alex-nemo/pic18f-raspberry-ups.X/pcb/pic18f-raspberry-ups-prototype.jpg

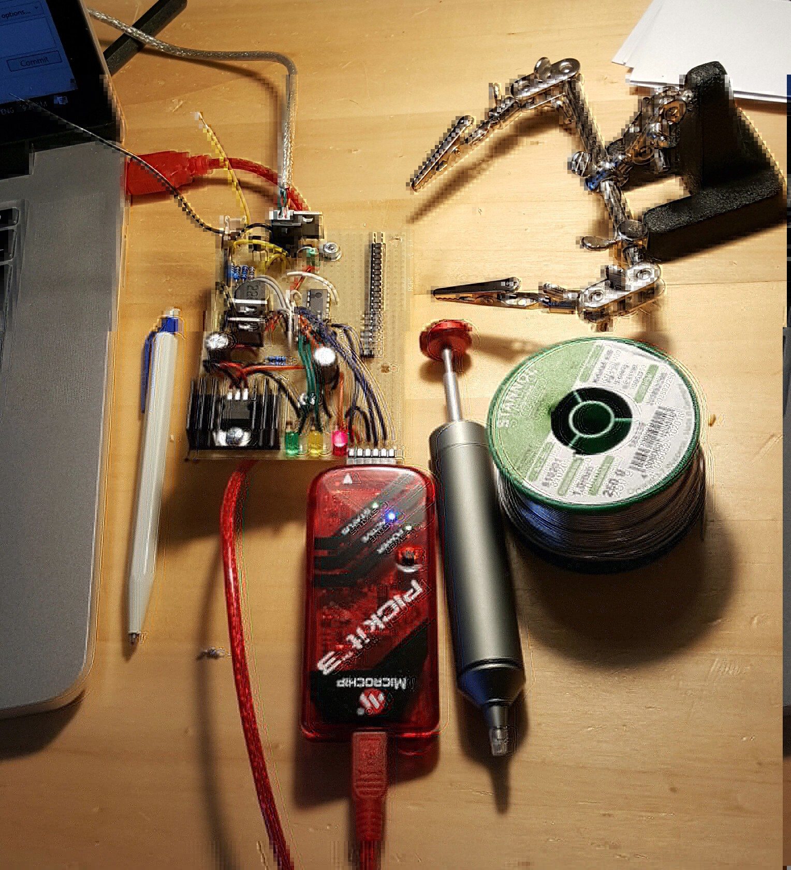
pcb/pic18f-raspberry-ups-prototype.jpg
