alex-nemo/pic18f-raspberry-ups.X/pcb/pic18f-raspberry-ups-3d.png

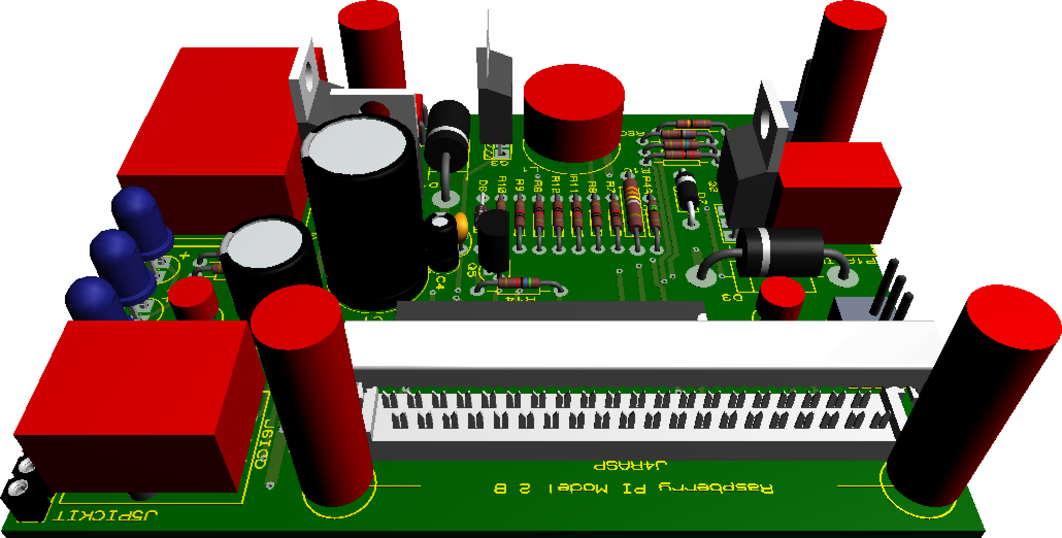
pcb/pic18f-raspberry-ups-3d.png
