alex-nemo/pic18f-raspberry-ups.X/pcb/gerber/pic18f-raspberry-ups - CADCAM Bottom Solder Resist.TXT

G04 PROTEUS RS274X GERBER FILE*
%FSLAX24Y24*%
%MOIN*%
%ADD72C,0.0400*%
%ADD71C,0.0024*%
%ADD17C,0.0800*%
%ADD14C,0.0700*%
%ADD18C,0.0900*%
%ADD73C,0.1000*%
%ADD30C,0.1600*%
%ADD16C,0.0600*%
%ADD22C,0.0503*%
%ADD24C,0.0413*%
%ADD25C,0.0080*%
G54D72*
X-11614Y+44488D03*
X-9645Y+24803D03*
X-35236Y+20866D03*
X-11614Y+41732D03*
X-30314Y+30708D03*
X-26377Y+24803D03*
X-31314Y+32677D03*
X-31329Y+27545D03*
X-34252Y+24346D03*
X-34251Y+21850D03*
X-22440Y+24803D03*
X-9645Y+39566D03*
X-16535Y+39566D03*
X-11614Y+38582D03*
X-10612Y+36048D03*
X-17324Y+36596D03*
X-17519Y+28740D03*
X-24409Y+28740D03*
X-21456Y+33661D03*
X-28469Y+33038D03*
X-20472Y+33661D03*
X-28914Y+32696D03*
X-28058Y+31497D03*
X-27339Y+31908D03*
X-26346Y+32285D03*
X-18298Y+34614D03*
X-18435Y+34134D03*
X-4724Y+33661D03*
X-12510Y+31977D03*
X-13538Y+31429D03*
X-17519Y+21850D03*
X-9645Y+20866D03*
X-18503Y+33661D03*
X-17305Y+33757D03*
X-14568Y+27094D03*
X-10947Y+27025D03*
X-8809Y+20059D03*
X-9055Y+25787D03*
X-27362Y+29724D03*
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
