alex-nemo/pic18f-raspberry-ups.X/pcb/gerber/pic18f-raspberry-ups - CADCAM Mechanical 1.TXT

G04 PROTEUS RS274X GERBER FILE*
%FSLAX24Y24*%
%MOIN*%
%ADD25C,0.0080*%
G54D25*
X-39173Y+18897D02*
X-1771Y+18897D01*
X-1771Y+46456D01*
X-39173Y+46456D01*
X-39173Y+18897D01*
X-34212Y+28700D02*
X-33818Y+28700D01*
X-33818Y+29960D01*
X-34212Y+29960D01*
X-34212Y+28700D01*
X-36653Y+28700D02*
X-36259Y+28700D01*
X-36259Y+29960D01*
X-36653Y+29960D01*
X-36653Y+28700D01*
X-35866Y+27165D02*
X-34606Y+27165D01*
X-34606Y+27559D01*
X-35866Y+27559D01*
X-35866Y+27165D01*
M00*
