alex-nemo/pic18f-raspberry-ups.X/documentation/1385285_GB_00_FB.EPS_400.jpg

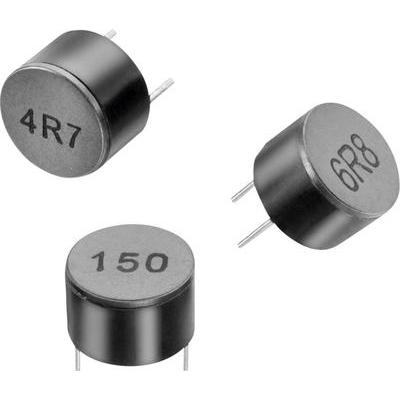
documentation/1385285_GB_00_FB.EPS_400.jpg
