alex-nemo/pic18f-raspberry-ups.X/documentation/L78S05CV.jpg

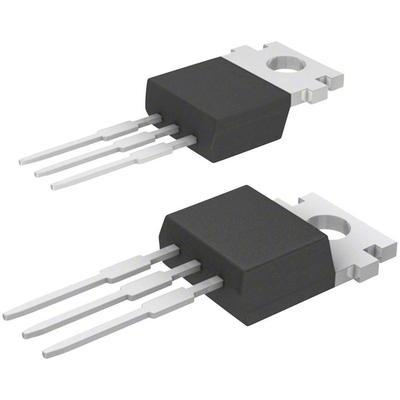
documentation/L78S05CV.jpg
