alex-nemo/pic18f-raspberry-ups.X/documentation/US18650VTC5A.jpg

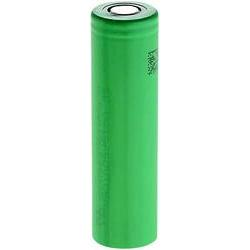
documentation/US18650VTC5A.jpg
