alex-nemo/pic18f-raspberry-ups.X/pcb/pic18f-raspberry-ups-pcb.png

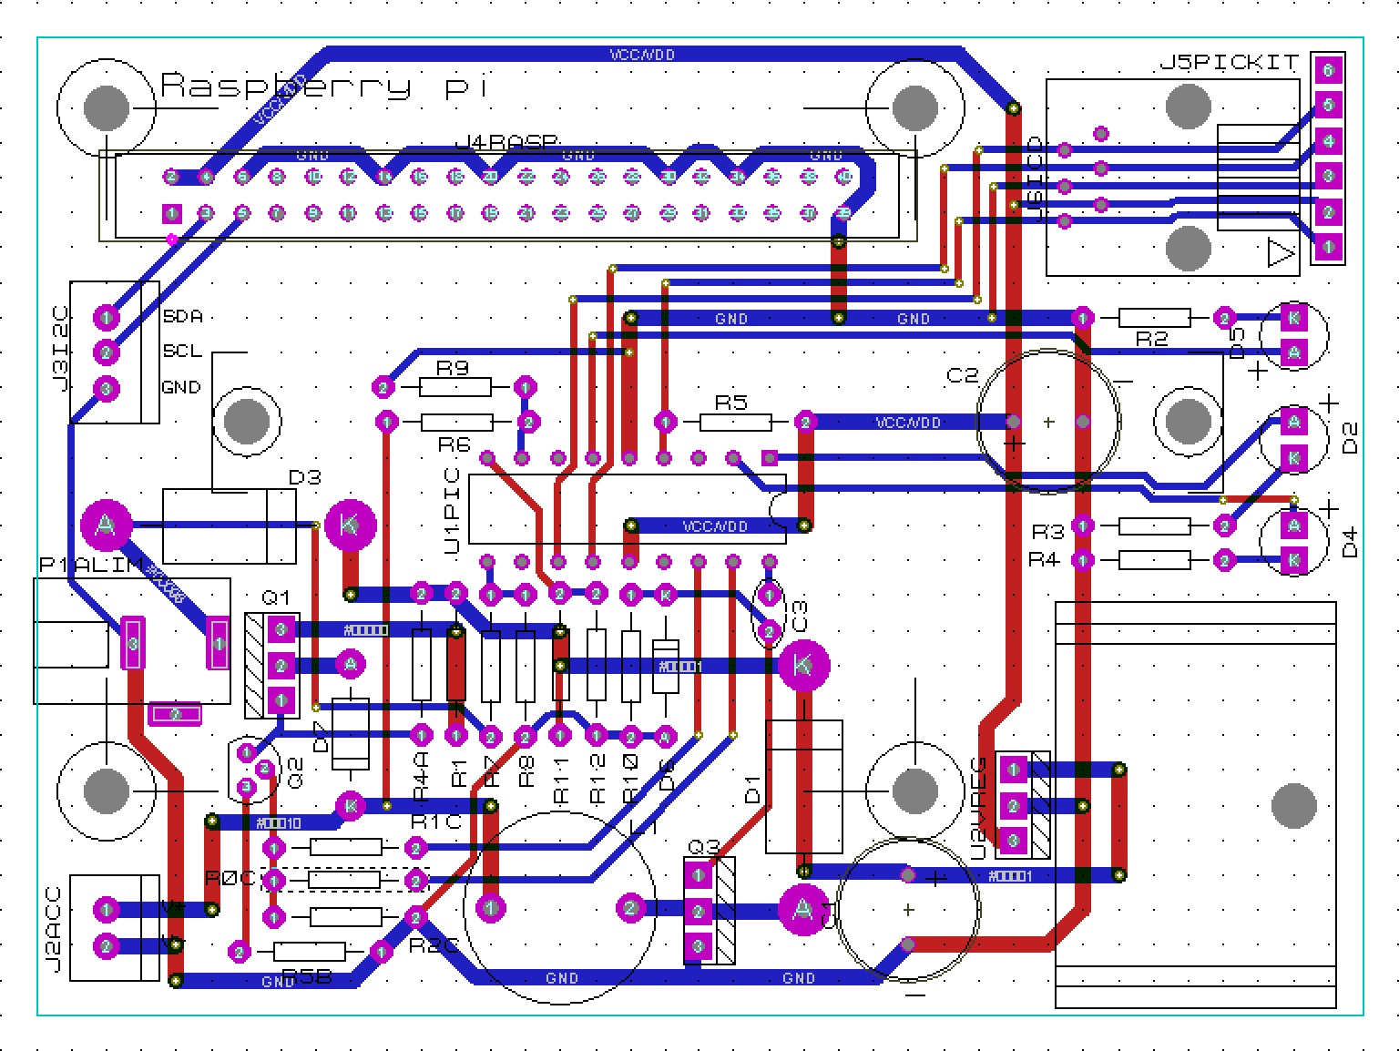
pcb/pic18f-raspberry-ups-pcb.png
