alex-nemo/pic18f-raspberry-ups.X/pcb/pic18f-raspberry-ups-pcb.pdf

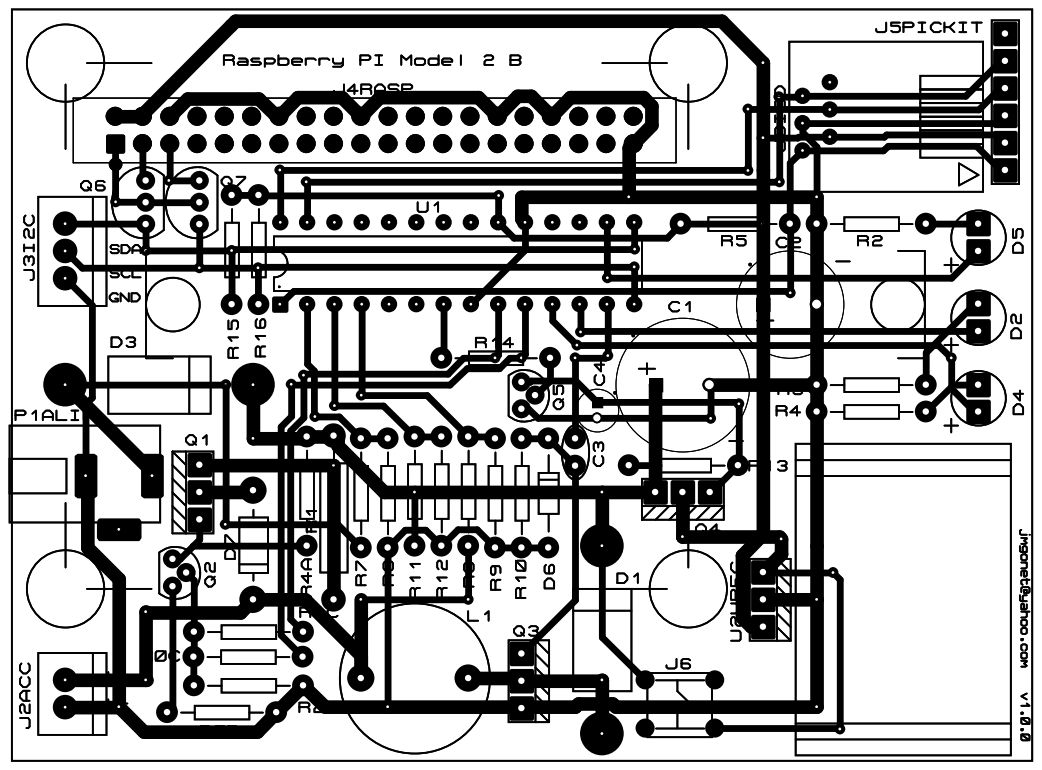
[picture p7: page 1]
