alex-nemo/pic18f-raspberry-ups.X/pcb/pic18f-raspberry-ups-sch.pdf

## J4RASP

R5

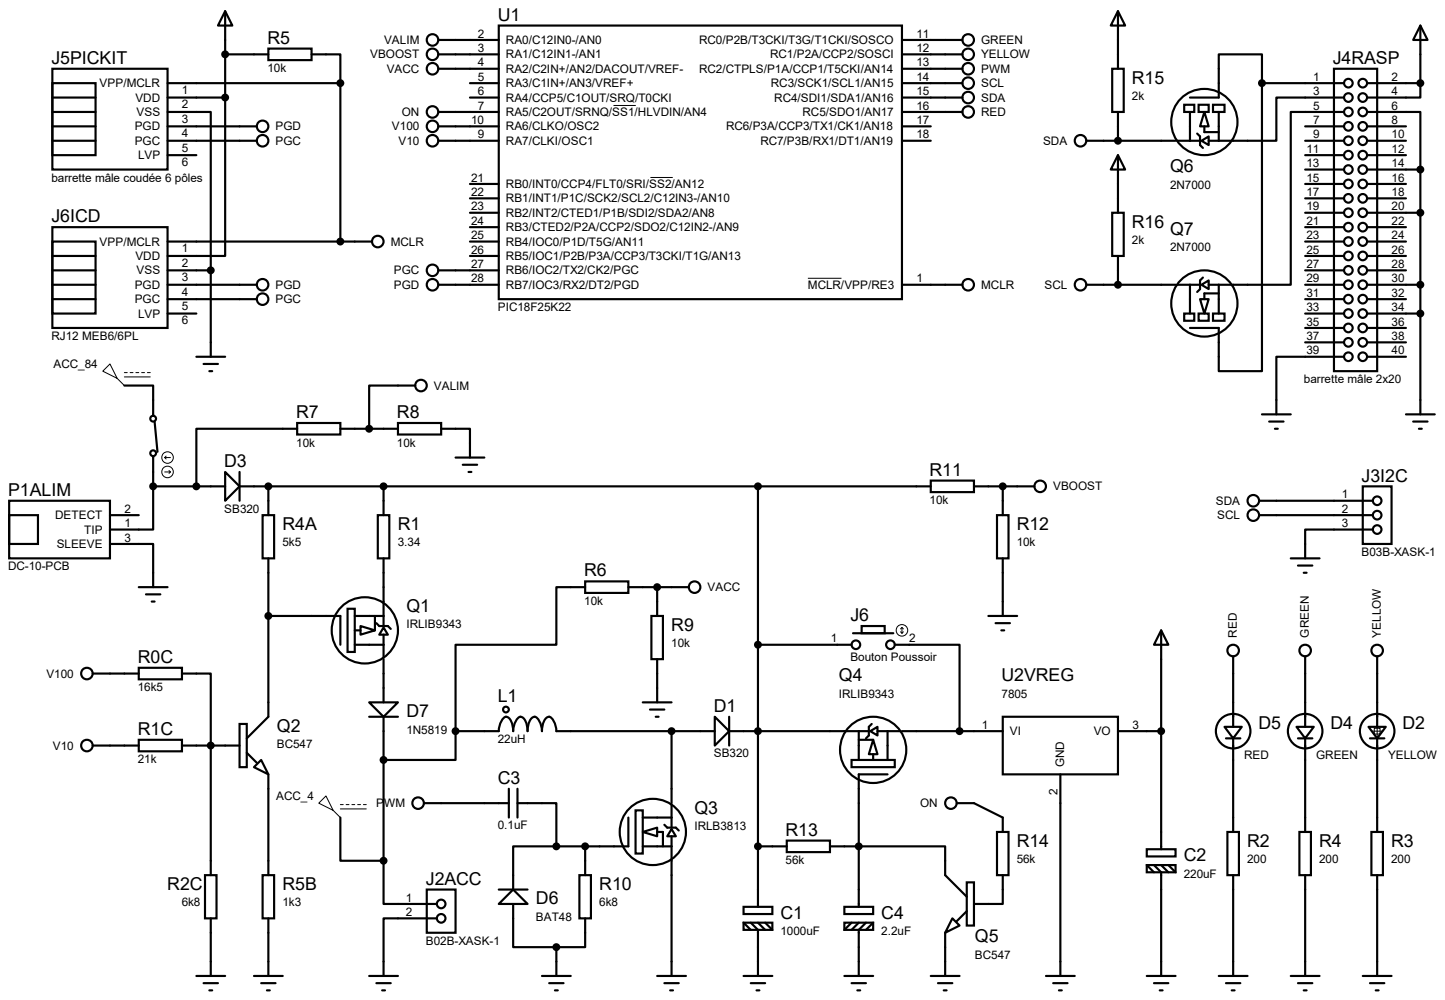
[picture p8: page 1]

barrette mâle coudée 6 pôles
