alex-nemo/pic18f-raspberry-ups.X/documentation/pic18f-raspberry-ups.pdf

## JRSPI JI2C

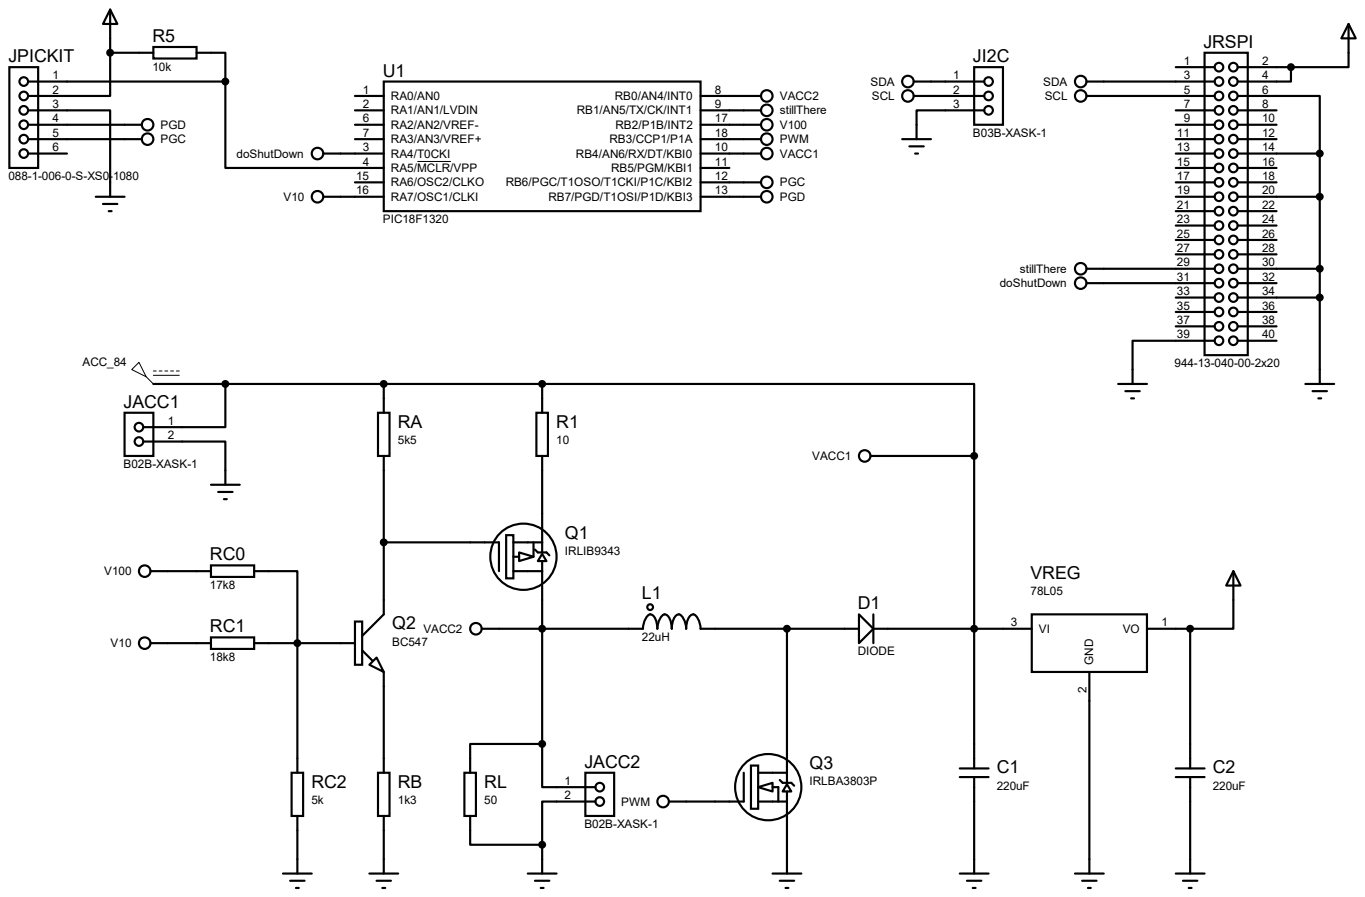
[picture p9: page 1]
