alex-nemo/pic18f-raspberry-ups.X/(list of files, drawings)

Other design files:
pcb/pic18f-raspberry-ups.pdsprj
