alex-nemo/pic18f-raspberry-ups.X/accumulateur.c

#include "accumulateur.h"
#include "test.h"

/** 
 * Énumère les états de l'accumulateur.
 */
typedef enum {
    /**
     * L'accumulateur est absent.
     */
    ABSENT,
    /**
     * L'accumulateur est présent, mais pas utilisable.
     */
    PAS_UTILISABLE,
    /**
     * L'accumulateur est utilisable, mais son niveau de charge est faible.
     */
    UTILISABLE_MAIS_FAIBLE,
    /**
     * L'accumulateur est utilisable.
     */
    UTILISABLE
} EtatAccumulateur;


/**
 * Énumère les états de la source d'alimentation.
 */
typedef enum {
    /**
     * L'alimentation est utilisable.
     */
    PRESENTE,
    /**
     * L'alimentation n'est pas utilisable.
     */
    DEFAILLANTE
} EtatAlimentation;


/**
 * Énumère les états du raspberry.
 */
typedef enum {
    /**
     * Le raspberry est probablement allumé, et a besoin de courant.
     */
    PROBABLEMENT_ACTIF,
    /**
     * Le raspberry ne consomme actuellement pas de courant.
     */
    INACTIF
} EtatRaspberry;

/** État actuel de l'accumulateur. */
static EtatAccumulateur etatAccumulateur = UTILISABLE;

/** État actuel de l'alimentation. */
static EtatAlimentation etatAlimentation = PRESENTE;

/** État actuel du raspberry. */
static EtatRaspberry etatRaspberry = PROBABLEMENT_ACTIF;

/**
 * Initialise les états internes.
 */
void initialiseAccumulateur() {
    etatAccumulateur = UTILISABLE;
    etatAlimentation = PRESENTE;
    etatRaspberry = PROBABLEMENT_ACTIF;
}

Accumulateur accumulateur;

/**
 * Calcule la configuration de l'accumulateur, selon les états de l'alimentation,
 * l'accumulateur et le raspberry.
 * @return La configuration de l'accumulateur.
 */
static Accumulateur *etatEnergie() {

    // Présence et disponibilité de l'accumulateur:
    accumulateur.accumulateurPresent = 0;
    accumulateur.accumulateurDisponible = 0;
    if (etatAccumulateur != ABSENT) {
        accumulateur.accumulateurPresent = 1;
    }
    if ( (etatAccumulateur == UTILISABLE) || (etatAccumulateur == UTILISABLE_MAIS_FAIBLE)) {
        accumulateur.accumulateurDisponible = 1;
    }


    // Chargement ou sollicitation de l'accumulateur:
    accumulateur.accumulateurEnCharge = 0;
    accumulateur.accumulateurSollicite = 0;
    if (etatAlimentation == PRESENTE) {
        accumulateur.accumulateurSollicite = 0;
        if ( (etatAccumulateur == PAS_UTILISABLE) || (etatAccumulateur == UTILISABLE_MAIS_FAIBLE)) {
            accumulateur.accumulateurEnCharge = 1;
        }
    } else {
        if ( (etatAccumulateur == UTILISABLE) || (etatAccumulateur == UTILISABLE_MAIS_FAIBLE)) {
            if (etatRaspberry == PROBABLEMENT_ACTIF) {
                accumulateur.accumulateurSollicite = 1;
            }
        }
    }

    // Rend l'état de l'accumulateur.
    return &accumulateur;
}

Accumulateur *mesureAlimentation(unsigned char v) {
    switch(etatAlimentation) {
        case PRESENTE:
            // Si l'alimentation tombe en dessous du 7.05V, elle n'est plus
            // utilisable.
            if (v < 180) {
                etatAlimentation = DEFAILLANTE;
            }
            break;

        case DEFAILLANTE:
            // Si l'alimentation remonte au dessus de 7.8V, elle est
            // utilisable à nouveau.
            if (v > 198) {
                etatAlimentation = PRESENTE;
            }
            break;
    }

    return etatEnergie();
}

Accumulateur *mesureBoost(unsigned char v) {
    switch(etatRaspberry) {
        // Si la tension de sortie du convertisseur boost dépasse 9.5V, c'est
        // parce que le raspberry a cessé de consommer du courant.
        case PROBABLEMENT_ACTIF:
            if (v > 241) {
                etatRaspberry = INACTIF;
            }
            break;
    }
    return etatEnergie();
}

Accumulateur *mesureAccumulateur(unsigned char vAccumulateur) {
    if ( (vAccumulateur < 50) || (vAccumulateur > 114)) {
        etatAccumulateur = ABSENT;
    } else {
        switch(etatAccumulateur) {
            case ABSENT:
                etatAccumulateur = PAS_UTILISABLE;
                break;
            case PAS_UTILISABLE:
                if (vAccumulateur > 80) {
                    etatAccumulateur = UTILISABLE_MAIS_FAIBLE;
                }
                break;
            case UTILISABLE_MAIS_FAIBLE:
                if (vAccumulateur < 80) {
                    etatAccumulateur = PAS_UTILISABLE;
                }
                if (vAccumulateur > 107) {
                    etatAccumulateur = UTILISABLE;
                }
                break;
            case UTILISABLE:
                if (vAccumulateur < 91) {
                    if (vAccumulateur < 80) {
                        etatAccumulateur = PAS_UTILISABLE;
                    } else {
                        etatAccumulateur = UTILISABLE_MAIS_FAIBLE;
                    }
                }
                break;
        }
    }

    return etatEnergie();
}


#ifdef TEST

// Conversion d'une tension x10 à la sortie d'un diviseur
// de tension (1/2) et convertie à 8 bits avec une référence de 5V.
// Exemple: 5 Volts ==> 50 ==> 127
#define CONVERSION_8BITS(x) ((x * 255)/100)

static void peut_detecter_que_l_accumulateur_est_present() {
    initialiseAccumulateur();
    verifieEgalite("ACCPR1", mesureAccumulateur(CONVERSION_8BITS(19))->accumulateurPresent, 0);
    verifieEgalite("ACCPR2", mesureAccumulateur(CONVERSION_8BITS(20))->accumulateurPresent, 1);
    verifieEgalite("ACCPR3", mesureAccumulateur(CONVERSION_8BITS(45))->accumulateurPresent, 1);
    verifieEgalite("ACCPR4", mesureAccumulateur(CONVERSION_8BITS(46))->accumulateurPresent, 0);
}

static void peut_completer_un_cycle_de_charge() {
    initialiseAccumulateur();    
    verifieEgalite("ACCCY01", mesureAccumulateur(CONVERSION_8BITS(42))->accumulateurEnCharge, 0);
    verifieEgalite("ACCCY02", mesureAccumulateur(CONVERSION_8BITS(39))->accumulateurEnCharge, 0);
    verifieEgalite("ACCCY03", mesureAccumulateur(CONVERSION_8BITS(36))->accumulateurEnCharge, 0);
    verifieEgalite("ACCCY04", mesureAccumulateur(CONVERSION_8BITS(35))->accumulateurEnCharge, 1);
    verifieEgalite("ACCCY05", mesureAccumulateur(CONVERSION_8BITS(39))->accumulateurEnCharge, 1);
    verifieEgalite("ACCCY06", mesureAccumulateur(CONVERSION_8BITS(42))->accumulateurEnCharge, 1);
    verifieEgalite("ACCCY07", mesureAccumulateur(CONVERSION_8BITS(43))->accumulateurEnCharge, 0);
    verifieEgalite("ACCCY08", mesureAccumulateur(CONVERSION_8BITS(42))->accumulateurEnCharge, 0);
    verifieEgalite("ACCCY09", mesureAccumulateur(CONVERSION_8BITS(38))->accumulateurEnCharge, 0);
    verifieEgalite("ACCCY10", mesureAccumulateur(CONVERSION_8BITS(36))->accumulateurEnCharge, 0);
    verifieEgalite("ACCCY11", mesureAccumulateur(CONVERSION_8BITS(35))->accumulateurEnCharge, 1);    
}

static void peut_detecter_que_l_accumulateur_est_disponible() {
    initialiseAccumulateur();
    
    verifieEgalite("ACCDI01", mesureAccumulateur(CONVERSION_8BITS(31))->accumulateurDisponible, 0);
    verifieEgalite("ACCDI02", mesureAccumulateur(CONVERSION_8BITS(32))->accumulateurDisponible, 1);
    verifieEgalite("ACCDI03", mesureAccumulateur(CONVERSION_8BITS(42))->accumulateurDisponible, 1);
    verifieEgalite("ACCDI04", mesureAccumulateur(CONVERSION_8BITS(43))->accumulateurDisponible, 1);
}

static void sollicite_l_accumulateur_si_l_alimentation_fait_defaut() {
    initialiseAccumulateur();
    mesureAccumulateur(CONVERSION_8BITS(40));
    verifieEgalite("ACCSOL01", mesureAlimentation(CONVERSION_8BITS(71))->accumulateurSollicite, 0);
    verifieEgalite("ACCSOL02", mesureAlimentation(CONVERSION_8BITS(70))->accumulateurSollicite, 1);
    verifieEgalite("ACCSOL03", mesureAlimentation(CONVERSION_8BITS(71))->accumulateurSollicite, 1);
    verifieEgalite("ACCSOL04", mesureAlimentation(CONVERSION_8BITS(78))->accumulateurSollicite, 1);
    verifieEgalite("ACCSOL04", mesureAlimentation(CONVERSION_8BITS(79))->accumulateurSollicite, 0);
    verifieEgalite("ACCSOL05", mesureAlimentation(CONVERSION_8BITS(78))->accumulateurSollicite, 0);
}

static void ne_sollicite_plus_l_accumulateur_si_le_raspberry_s_eteint() {
    initialiseAccumulateur();
    mesureAccumulateur(CONVERSION_8BITS(40));
    mesureAlimentation(CONVERSION_8BITS(60));
    verifieEgalite("ACCAU01", mesureBoost(CONVERSION_8BITS(85))->accumulateurSollicite, 1);
    verifieEgalite("ACCAU02", mesureBoost(CONVERSION_8BITS(90))->accumulateurSollicite, 1);
    verifieEgalite("ACCAU03", mesureBoost(CONVERSION_8BITS(95))->accumulateurSollicite, 0);
}

static void ne_solicite_plus_l_accumulateur_si_il_est_pas_disponible() {
    initialiseAccumulateur();
    
    mesureAccumulateur(CONVERSION_8BITS(41));
    verifieEgalite("ACCSL01", mesureAlimentation(CONVERSION_8BITS(59))->accumulateurSollicite, 1);
    
    mesureAccumulateur(CONVERSION_8BITS(32));
    verifieEgalite("ACCSL02", mesureAlimentation(CONVERSION_8BITS(59))->accumulateurSollicite, 1);

    mesureAccumulateur(CONVERSION_8BITS(31));
    verifieEgalite("ACCSL03", mesureAlimentation(CONVERSION_8BITS(59))->accumulateurSollicite, 0);

    mesureAccumulateur(CONVERSION_8BITS(32));
    verifieEgalite("ACCSL04", mesureAlimentation(CONVERSION_8BITS(59))->accumulateurSollicite, 1);
}

static void ne_solicite_pas_l_accumulateur_si_il_est_pas_disponible() {
    initialiseAccumulateur();

    mesureAccumulateur(CONVERSION_8BITS(31));
    verifieEgalite("ACCSD01", mesureAlimentation(CONVERSION_8BITS(59))->accumulateurSollicite, 0);
    
}

static void ne_solicite_pas_l_accumulateur_si_il_est_pas_present() {
    initialiseAccumulateur();

    mesureAccumulateur(CONVERSION_8BITS(19));
    verifieEgalite("ACCSP01", mesureAlimentation(CONVERSION_8BITS(59))->accumulateurSollicite, 0);
}

void testeAccumulateur() {
    peut_detecter_que_l_accumulateur_est_present();
    peut_detecter_que_l_accumulateur_est_disponible();
    peut_completer_un_cycle_de_charge();
    
    sollicite_l_accumulateur_si_l_alimentation_fait_defaut();
    ne_sollicite_plus_l_accumulateur_si_le_raspberry_s_eteint();
 
    ne_solicite_plus_l_accumulateur_si_il_est_pas_disponible();
    ne_solicite_pas_l_accumulateur_si_il_est_pas_disponible();
    ne_solicite_pas_l_accumulateur_si_il_est_pas_present();
}

#endif
