alex-nemo/pic18f-raspberry-ups.X/i2c.h

#ifndef I2C__H
#define I2C__H

#define  I2C_MASQUE_ADRESSES_LOCALES 0b00000011
#define I2C_MASQUE_ADRESSES_ESCLAVES 0b11111000

typedef enum {
    LECTURE_ALIMENTATION  = 0b00011000,
    LECTURE_BOOST         = 0b00011001,
    LECTURE_ACCUMULATEUR  = 0b00011010,
    LECTURE_ERREUR        = 0b00011011
} I2cAdresse;

typedef struct {
    I2cAdresse adresse;
    unsigned char valeur;
} I2cCommande;

typedef void (*I2cRappelCommande)(unsigned char, unsigned char);
void i2cRappelCommande(I2cRappelCommande r);
void i2cExposeValeur(unsigned char adresse, unsigned char valeur);
void i2cPrepareCommandePourEmission(I2cAdresse adresse, unsigned char valeur);
unsigned char i2cDonneesDisponiblesPourEmission();
unsigned char i2cRecupereCaracterePourEmission();

void i2cMaitre();
void i2cEsclave();

void i2cReinitialise();

#ifdef TEST
void testI2c();
#endif

#endif
