alex-nemo/pic18f-raspberry-ups.X/test.h

#ifndef TEST_H
#define	TEST_H

#ifdef TEST

/**
 * Initialise la console de test.
 */
void initialiseTests();

/**
 * Vérifie si la valeur obtenue est égale à la valeur attendue.
 * @param testId Identifiant du test.
 * @param value Valeur obtenue.
 * @param expectedValue Valeur attendue.
 * @return 1 si le test échoue, ce qui permet de compter le nombre
 * de tests en erreur.
 */
unsigned char verifieEgalite(const char *testId, int value, int expectedValue);

/**
 * Affiche le nombre de tests en échec.
 */
void finaliseTests();

#endif

#endif
