alex-nemo/pic18f-raspberry-ups.X/(commit log)

2016-06-27 Version initiale, sur la base d'un moteur
    [circuit.pdsprj, pic18f-raspberry-ups.pdsprj]
2016-12-20 Première version du PCB. Tout est à tester
    [calculs-chargeur-nimh.ods, chargeur-nimh.ods, pic18f-raspberry-ups.pdsprj]
2017-01-09 Le convertisseur boost fonctionne avec l'ébauche du contrôleur.
    [pic18f-raspberry-ups.pdsprj]
2017-01-13 Adaptation du chargeur LiIon et tests sur le simulateur.
    [calculs-chargeur-liion.ods, pic18f-raspberry-ups.pdsprj]
2017-01-21 Closes #5 - Prototype terminé, connexion avec le PC réussie. Remplacé dans le schéma le composant 78L05 par le 7805: les entrées Vin et Vout sont inversée.
    [pic18f-raspberry-ups.pdsprj]
2017-01-22 #6 - Correction de la mesure VACC2: Si l'accumulateur secondaire est absent, la tension VACC2 peut monter jusqu'à la tension de l'accumulateur principal moins 1V, et ceci force le port du PIC. Il fau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
    [pic18f-raspberry-ups.pdsprj]
2017-01-23 #6 - Première version de l'algorithme avec le cycle de charge. Les tests unitaires passent. À tester sur le prototype.
2017-01-27 #4 - Refactorisation. Refactorisation des tests unitaires pour les rendre plus lisibles. Ajout de la méthode de gestion de l'alimentation (pas testée)
2017-01-28 Closes #6 - Cycle de charge complété avec les interactions entre la charge de l'accumulateur et la détection de défauts d'alimentation #4
2017-01-28 #4 - La mesure de l'alimentation doit se faire depuis avant la diode d'entrée. Autrement on mesure la décharge du condensateur.
    [pic18f-raspberry-ups.pdsprj]
2017-01-29 Amélioration du message à la fin des tests
2017-01-31 #4 - Attention à protéger le convertisseur Boost contre un blocage du signal PWM à niveau haut.
    [pic18f-raspberry-ups.pdsprj]
2017-02-04 #4 - Lancer la conversion boot lorsque la tension d'alimentation tombe en dessous du seuil.
2017-02-11 Closes #7 - Le cycle de travail doit être à 50% pour passer de 4.2V à 8.4V.
2017-02-12 PDF et PNG sont des fichiers binaires.
2017-02-12 Closes #12 - Connecteur coaxial pour l'alimentation, Closes #11 - Déplacement du connecteur PICKIT au bord de la plaque, Closes #10 - Remplacement des diodes, #9 - Diviseur de tension + connexion à A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
    [pic18f-raspberry-ups.pdsprj]
2017-02-15 #9 - Il est nécessaire d'ajouter une diode sur le chargeur de l'accumulateur, car le MOSFET laisse passer le courant inverse.
2017-02-18 #9 #8 Avertir de la chute d'alimentation avec un LED, et détecter que le raspberry est éteint.
    [pic18f-raspberry-ups.pdsprj]
2017-02-21 #9 #8 Avertir de la chute d'alimentation avec un LED, et détecter que le raspberry est éteint. Refactorisation du code.
2017-02-24 Closes #9, Closes #8 - Détecte l'arrêt du raspberry et coupe le convertisseur boost.
2017-03-02 #9 - Il est nécessaire de bloquer l'arrivée de courant sur le régulateur, pour l'isoler convenablement de toute source de courant.
2017-03-02 #13 - Changé le micro-contrôleur par un PIC18F2xK22
    [pic18f-raspberry-ups.pdsprj]
2017-03-02 #15 - Commander v1.0.0
    [pic18f-raspberry-ups.pdsprj]
2017-03-19 #15 - Adaptations de la BOM et du circuit en vue de la commande du circuit.
    [pic18f-raspberry-ups.pdsprj]
2017-03-22 #13 - Changer le micro-contrôleur actuel par un qui supporte I2C - Adaptations pour le nouveau processeur, sans ajout de fonctionnalité.
2017-03-22 #13 - Changer le micro-contrôleur actuel par un qui supporte I2C - Ajout du code pour l'esclave I2C. Exposition des niveaux Alimentation, Accumulateur et Boost.
2017-03-26 #13 - Corrections après tests avec i2ctools du raspberry. Il y a encore une chicane avec i2cdetect.
    [i2c.h, main.c]
2017-03-26 #16 - Tests unitaires pour les scénarios où l'accumulateur est connecté après l'allumage du module
2017-03-28 #13 - Corrections après tests avec i2ctools du raspberry. Correction de l'état 3, selon AN00734b il faut lire et désactiver le flag BF.
2017-03-29 Closes #16 - Éviter de démarrer un cycle de charge dès qu'on connecte l'accumulateur
2017-04-01 Closes #14 - Les interruptions I2C peuvent perturber les interruptions AD. Vérifier qu'il n'y a pas de conversion en cours lors du traitement de l'interruption AD. Aussi, j'ai ajouté un status d'erre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
2017-05-01 Closes #17 - Ajuster les niveaux I2C entre le Raspberry (3.3V) et l'extérieur (5.0V)
    [pic18f-raspberry-ups.pdsprj]
